electrodonkey/angst/hardware/docs/Angst_3D.PNG

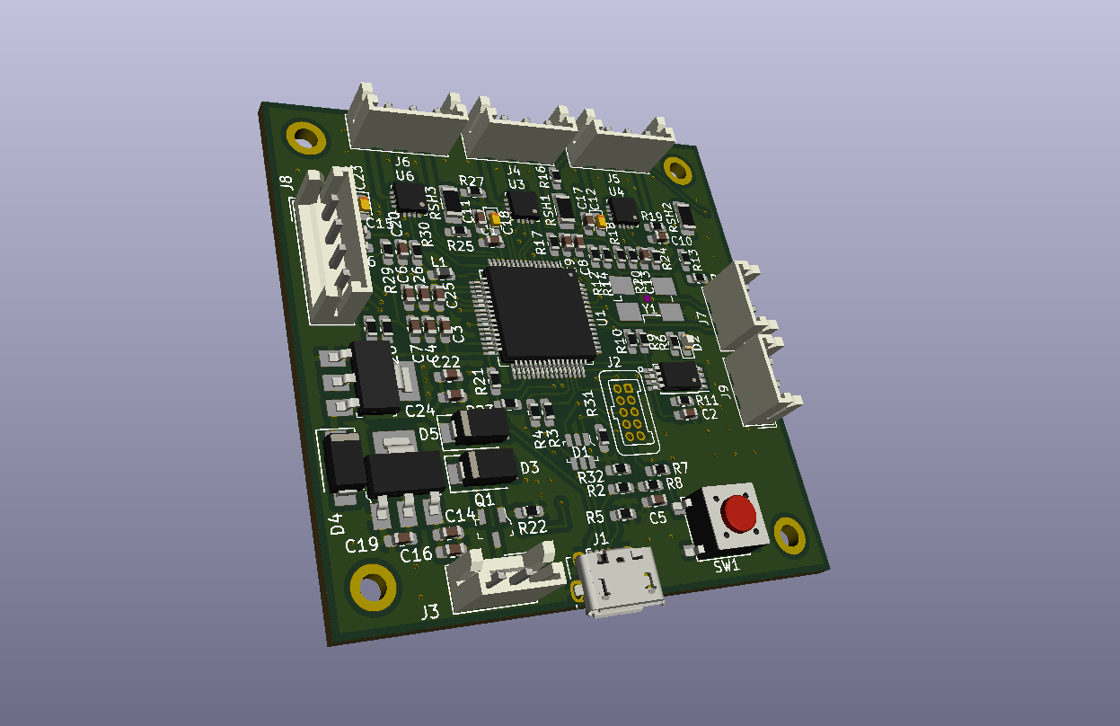
hardware/docs/Angst_3D.PNG
