electrodonkey/angst/README.md

# ANGST - Angle seNsor Gimbal SysTem

## Master thesis project in Advanced Microelectronics
