electrodonkey/angst/hardware/docs/Angst_Shopping_Cart.xlsx

ANGST BOM v1.0.0 | 2019-04-26
Reference | Value | Footprint | Quantity/Unit | Unit price | Total Price/Unit | Quantity to buy | Total Price | Mouser PN
R1, R5 | 100k | Resistor_SMD:R_0603_1608Metric_Pad1.05x0.95mm_HandSolder | 2 | 0.02 € | 0.04 € | 50 | 0.95 € | 603-AC0603FR-07100KL
Y1 | Crystal_GND24 | Crystal:Crystal_SMD_0603-4Pin_6.0x3.5mm_HandSoldering | 1 | 0.86 € | 0.86 € | 3 | 2.57 € | 774-406I35D08M00000
U1 | STM32F303RETx | Package_QFP:LQFP-64_10x10mm_P0.5mm | 1 | 6.28 € | 6.28 € | 3 | 18.84 € | 511-STM32F303RET6
L1 | BK1608HS601-T | Inductor_SMD:L_0603_1608Metric_Pad1.05x0.95mm_HandSolder | 1 | 0.04 € | 0.04 € | 50 | 2.05 € | 963-BK1608HS601-T
C1, C2, C3, C4, C5, C6, C7, C16, C24, C25 | 100n | Capacitor_SMD:C_0603_1608Metric_Pad1.05x0.95mm_HandSolder | 10 | 0.03 € | 0.26 € | 100 | 2.60 € | 710-885012206071
U2 | M24C02-RDW | Package_SO:TSSOP-8_4.4x3mm_P0.65mm | 1 | 0.11 € | 0.11 € | 10 | 1.07 € | 511-M24C02-RDW6TP
R8, R9, R10 | 4k7 | Resistor_SMD:R_0603_1608Metric_Pad1.05x0.95mm_HandSolder | 3 | 0.01 € | 0.01 € | 100 | 0.50 € | 603-RC0603FR-074K7L
R11, R14, R20, R27 | 10k | Resistor_SMD:R_0603_1608Metric_Pad1.05x0.95mm_HandSolder | 4 | 0.01 € | 0.02 € | 200 | 1.00 € | 603-RC0603FR-0710KL
SW1 | SW_Push | Button_Switch_SMD:SW_SPST_EVPBF | 1 | 0.35 € | 0.35 € | 5 | 1.74 € | 612-TL3301CF160QJ
R3, R4, R7 | 22 | Resistor_SMD:R_0603_1608Metric_Pad1.05x0.95mm_HandSolder | 3 | 0.01 € | 0.04 € | 100 | 1.20 € | 71-CRCW060322R0FKEAC
D2 | LED | LED_SMD:LED_0603_1608Metric_Pad1.05x0.95mm_HandSolder | 1 | 0.08 € | 0.08 € | 20 | 1.58 € | 743-IN-S63AT5G
R6 | 560 | Resistor_SMD:R_0603_1608Metric_Pad1.05x0.95mm_HandSolder | 1 | 0.01 € | 0.01 € | 200 | 1.00 € | 603-RC0603FR-07560RL
U3, U4, U6 | STSPIN233 | digikey-footprints:VFQFN-16-1EP_3x3mm | 3 | 2.20 € | 6.60 € | 6 | 13.20 € | 511-STSPIN233
R12, R18, R25 | 100 | Resistor_SMD:R_0603_1608Metric_Pad1.05x0.95mm_HandSolder | 3 | 0.01 € | 0.01 € | 200 | 1.00 € | 603-RC0603FR-07100RL
R13, R17, R19, R24, R26, R30 | 18k | Resistor_SMD:R_0603_1608Metric_Pad1.05x0.95mm_HandSolder | 6 | 0.01 € | 0.03 € | 200 | 1.00 € | RC0603FR-0718KL
C8, C9, C10, C11, C13, C15, C17, C20, C21 | 10n | Capacitor_SMD:C_0603_1608Metric_Pad1.05x0.95mm_HandSolder | 9 | 0.02 € | 0.19 € | 100 | 2.10 € | 710-885012206089
R16, R23, R29 | 1k | Resistor_SMD:R_0603_1608Metric_Pad1.05x0.95mm_HandSolder | 3 | 0.01 € | 0.03 € | 100 | 1.00 € | 71-CRCW06031K00FKEAC
R15, R21, R28 | 3k | Resistor_SMD:R_0603_1608Metric_Pad1.05x0.95mm_HandSolder | 3 | 0.01 € | 0.01 € | 200 | 1.00 € | 603-RC0603FR-073KL
C12, C18, C23 | 22uF 20V | Capacitor_Tantalum_SMD:CP_EIA-1608-08_AVX-J_Pad1.25x1.05mm_HandSolder | 3 | 0.17 € | 0.50 € | 10 | 1.66 € | TAJB226K016TNJ
RSH1, RSH2, RSH3 | 1 0.5W | Resistor_SMD:R_1206_3216Metric_Pad1.42x1.75mm_HandSolder | 3 | 0.06 € | 0.17 € | 20 | 1.16 € | RLP73K2B1R0JTD
J4, J5, J6 | Conn_01x03 | Connector_JST:JST_EH_B3B-EH-A_1x03_P2.50mm_Vertical | 3 | 0 | 0.00 € | 10 | 0.00 €
J2 | Conn_02x05_Odd_Even | Connector_Harwin:Harwin_Gecko-G125-FVX1005L0X_2x05_P1.25mm_Vertical | 1 | 0 | 0.00 € | 3 | 0.00 €
D5 | STPS2L30 | Diode_SMD:D_SMA | 1 | 0.31 € | 0.31 € | 10 | 3.13 € | 511-STPS2L30A
C14, C19, C22, C26 | 1u | Capacitor_SMD:C_0603_1608Metric_Pad1.05x0.95mm_HandSolder | 4 | 0.03 € | 0.12 € | 50 | 1.50 € | CGA3E1X7R1C105M080AC
J1 | USB_B_Micro | Connector_USB:USB_Micro-B_Molex-105017-0001 | 1 | 0.68 € | 0.68 € | 5 | 3.41 € | 538-105017-0001
D1 | USBLC6-4SC6 | digikey-footprints:SOT23-6L | 1 | 0.42 € | 0.42 € | 6 | 2.51 € | 511-USBLC6-4SC6
R2 | 1k5 | Resistor_SMD:R_0603_1608Metric_Pad1.05x0.95mm_HandSolder | 1 | 0.01 € | 0.01 € | 200 | 1.00 € | RC0603FR-071K5L
U7 | TLV1117-33 | digikey-footprints:SOT-223 | 1 | 0.54 € | 0.54 € | 5 | 2.70 € | 595-TLV1117-33CDCYR
U5 | TLV1117-50 | digikey-footprints:SOT-223 | 1 | 0.54 € | 0.54 € | 5 | 2.70 € | 595-TLV1117-50CDCYR
Q1 | IRLML6401TRPBF | digikey-footprints:SOT-23-3 | 1 | 0.37 € | 0.37 € | 5 | 1.83 € | 942-IRLML6401TRPBF
R22 | 2k2 | Resistor_SMD:R_0603_1608Metric_Pad1.05x0.95mm_HandSolder | 1 | 0.01 € | 0.01 € | 200 | 1.00 € | 603-RC0603FR-072K2L
D3 | SMAJ8.5CALFCT-ND | Diode_SMD:D_SMA | 1 | 0.39 € | 0.39 € | 5 | 1.97 € | 576-SMAJ8.5CA
D4 | STPS2L30 | Diode_SMD:D_SMA | 1 | 0 | 0.00 € | 0 | 0.00 €
R31, R32 | 47k | Resistor_SMD:R_0603_1608Metric_Pad1.05x0.95mm_HandSolder | 2 | 0.01 € | 0.01 € | 200 | 1.00 € | RC0603JR-0747KL
J3, J7, J9 | Conn_01x02_Male | Connector_JST:JST_EH_B2B-EH-A_1x02_P2.50mm_Vertical | 3 | 0 | 0.00 € | 10 | 0.00 €
J8 | Conn_01x04_Male | Connector_JST:JST_EH_B4B-EH-A_1x04_P2.50mm_Vertical | 1 | 0 | 0.00 € | 10 | 0.00 €
 |  |  | TOTAL |  | 19.03 |  | 79.972
