electrodonkey/angst/hardware/pcb/angst.pdf

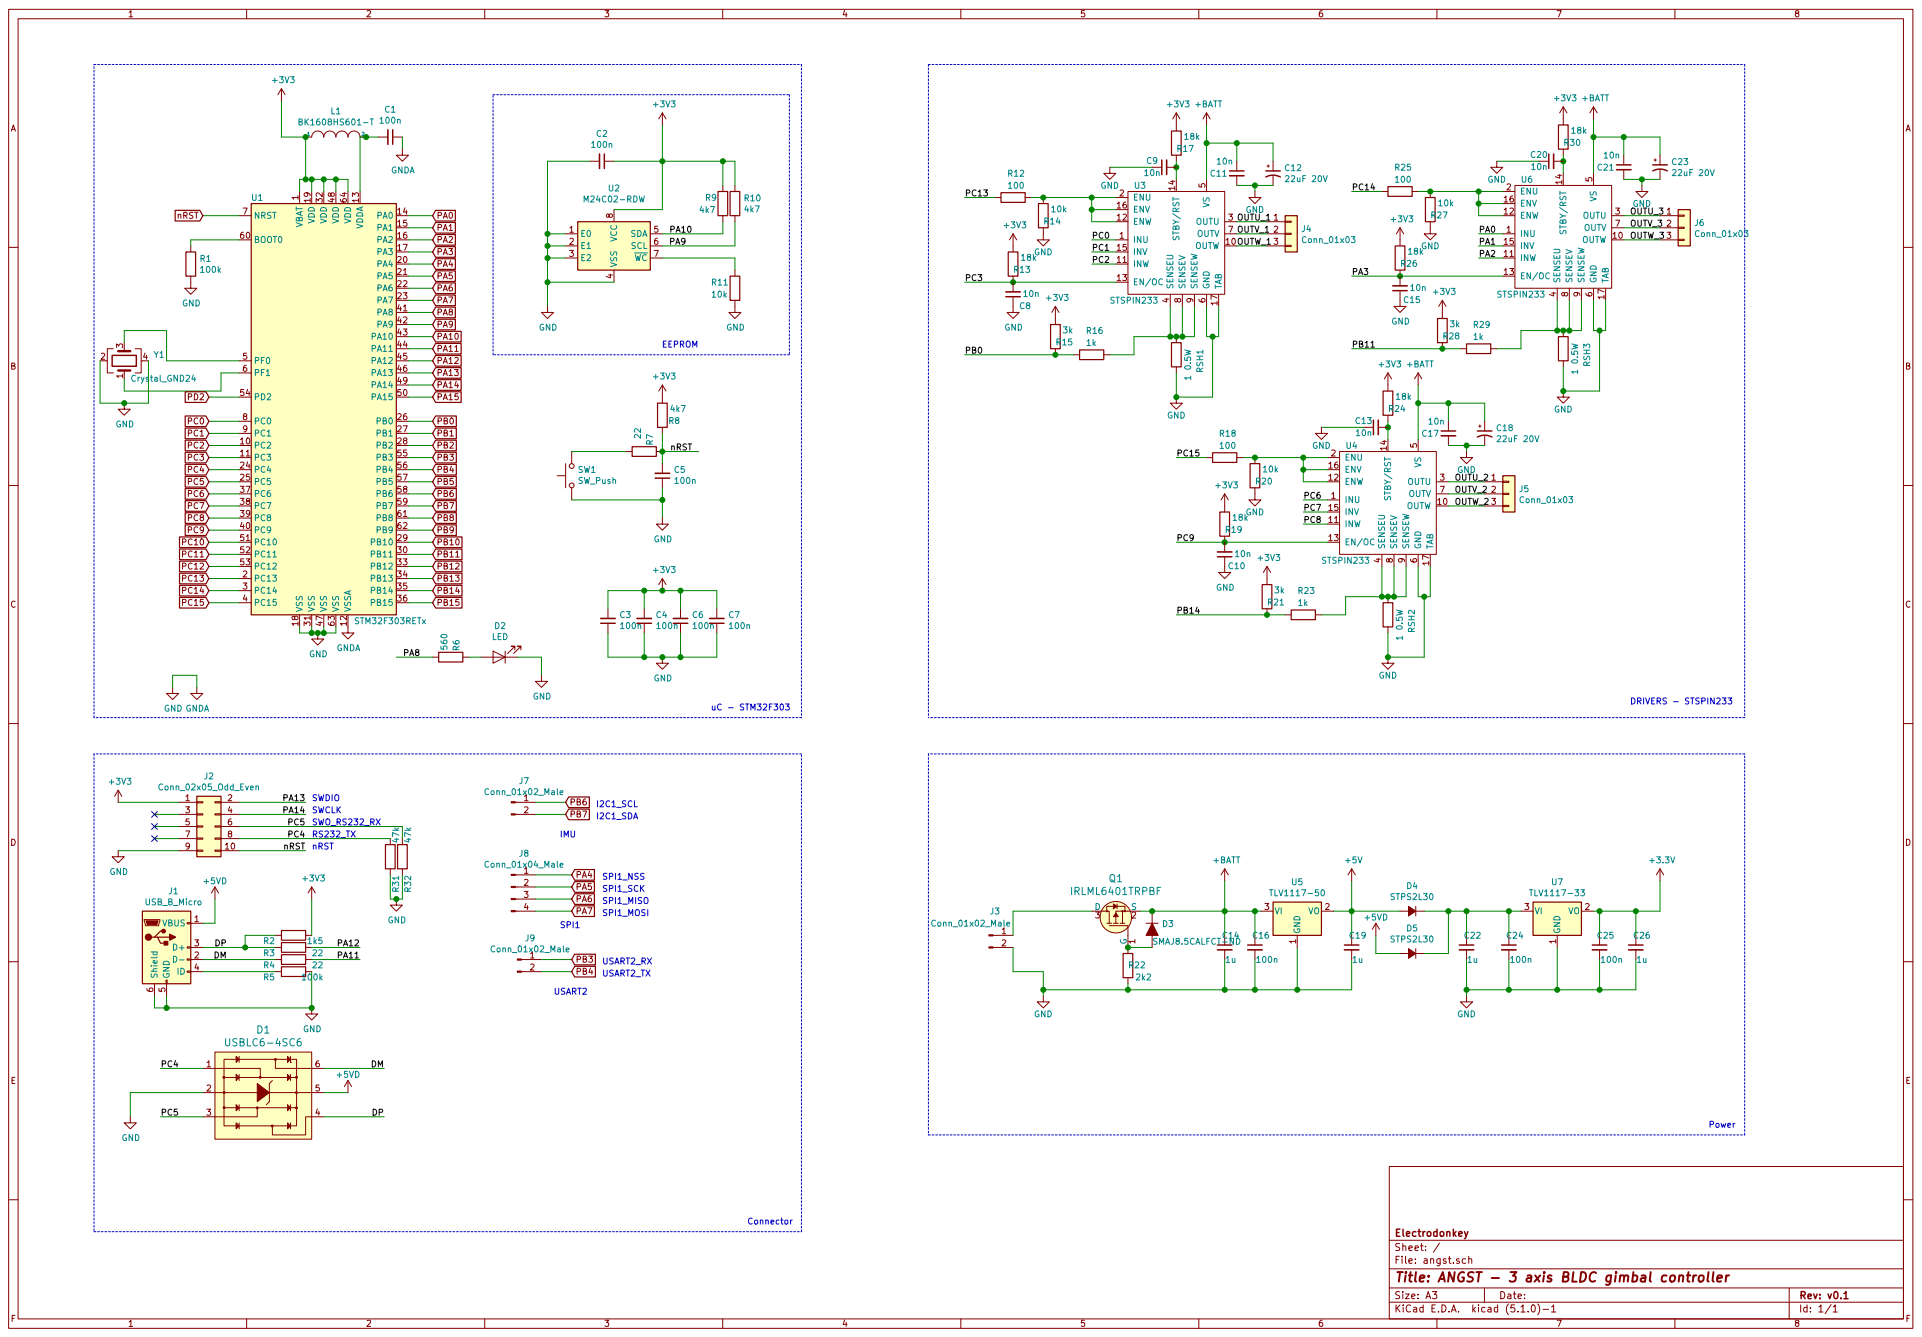
[picture p2: page 1]

1 VDD 19 VDD 32 VDD 48 VDD 64 VDDA 13 VSS 18 VSS 31 VSS 47 VSS 63 VSSA 12 U1 STM32F303RETx PD2 PC0 PC1 PC2 PC3 PC4 PC5 PC6 PC7 PC8 PC9 PC10 PC11 PC12 PC13 PC14 PC15 GND

4 SDA 5 SCL 6 WC 7 VCC

Id: 1/1 Title: ANGST - 3 axis BLDC gimbal controller File: angst.sch Sheet: / Electrodonkey
