electrodonkey/angst/hardware/pcb/angst.kicad_pcb

## KiCad design hardware/pcb/angst.kicad_pcb (2019-04-26)

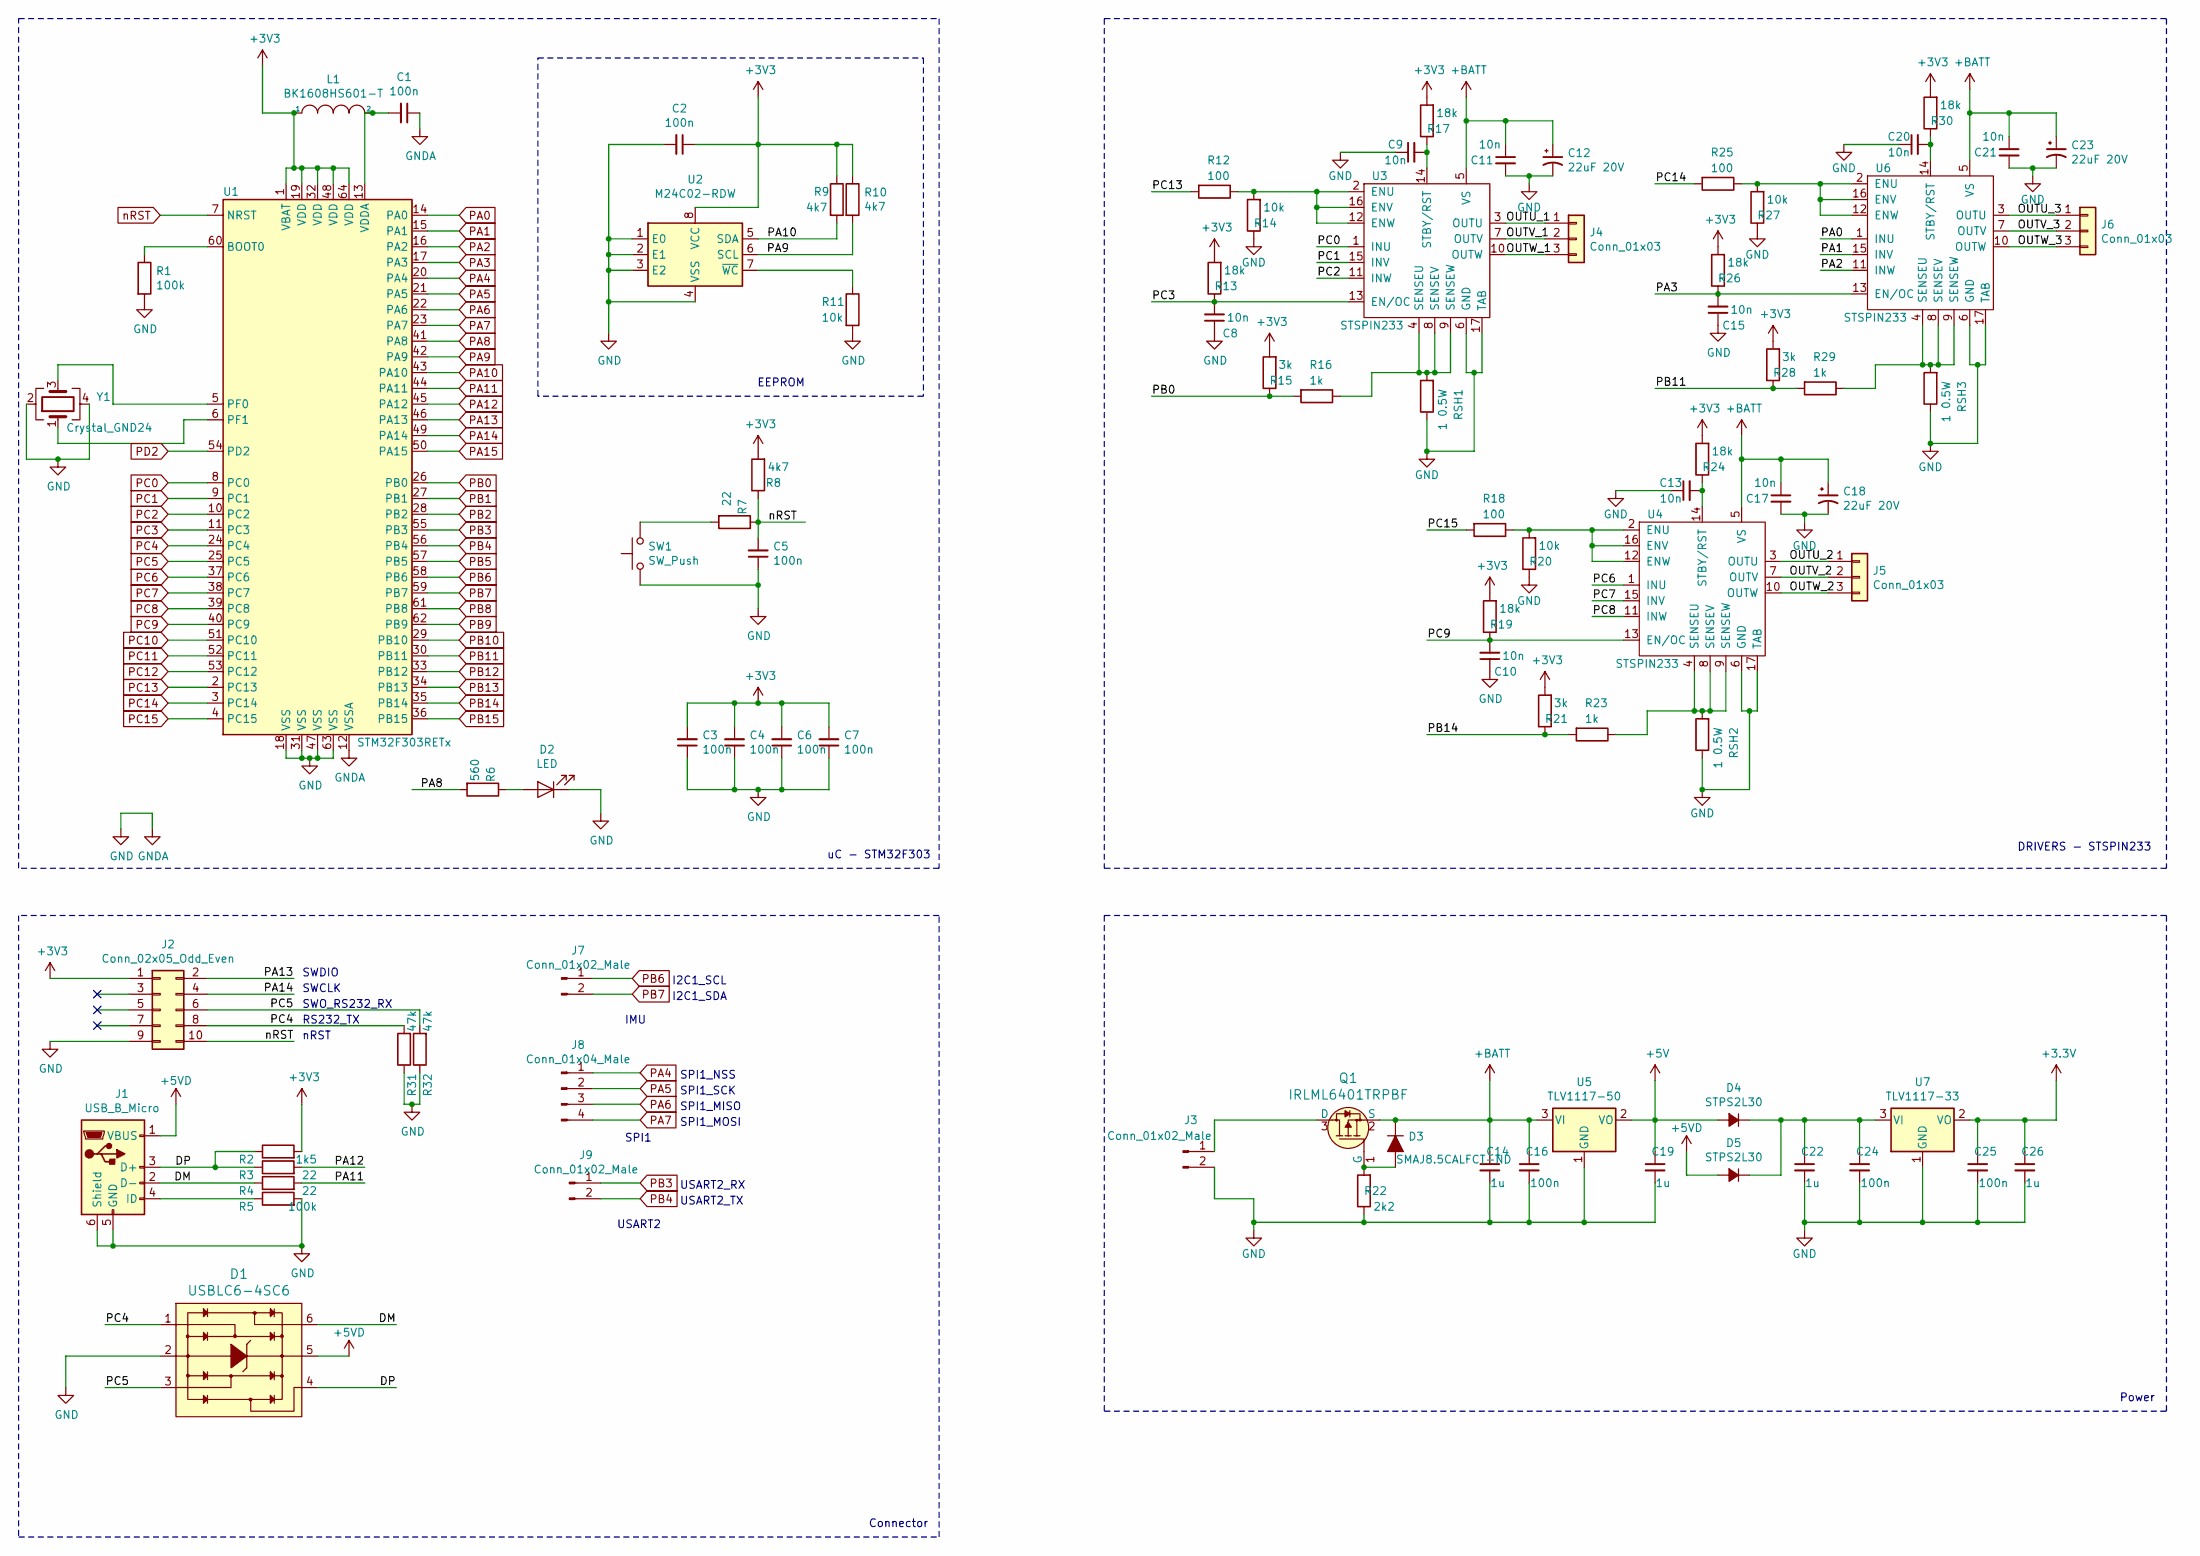
[picture p3: schematic angst.sch, ANGST - 3 axis BLDC gimbal controller]

Parts:
C1, C2, C3, C4, C5, C6, C7, C16, C24, C25: 100n; C_0603_1608Metric_Pad1.05x0.95mm_HandSolder
C8, C9, C10, C11, C13, C15, C17, C20, C21: 10n; C_0603_1608Metric_Pad1.05x0.95mm_HandSolder
C12, C18, C23: 22uF 20V; CP_EIA-1608-08_AVX-J_Pad1.25x1.05mm_HandSolder
C14, C19, C22, C26: 1u; C_0603_1608Metric_Pad1.05x0.95mm_HandSolder
D1: USBLC6-4SC6; SOT23-6L; MPN USBLC6-4SC6; Digi-Key_PN 497-4492-1-ND
D2: LED; LED_0603_1608Metric_Pad1.05x0.95mm_HandSolder
D3: SMAJ8.5CALFCT-ND; D_SMA
D4, D5: STPS2L30; D_SMA
J1: USB_B_Micro; USB_Micro-B_Molex-105017-0001
J2: Conn_02x05_Odd_Even; Harwin_Gecko-G125-FVX1005L0X_2x05_P1.25mm_Vertical
J3, J7, J9: Conn_01x02_Male; JST_EH_B2B-EH-A_1x02_P2.50mm_Vertical
J4, J5, J6: Conn_01x03; JST_EH_B3B-EH-A_1x03_P2.50mm_Vertical
J8: Conn_01x04_Male; JST_EH_B4B-EH-A_1x04_P2.50mm_Vertical
L1: BK1608HS601-T; L_0603_1608Metric_Pad1.05x0.95mm_HandSolder
Q1: IRLML6401TRPBF; SOT-23-3; MPN IRLML6401TRPBF; Digi-Key_PN IRLML6401PBFCT-ND
R1, R5: 100k; R_0603_1608Metric_Pad1.05x0.95mm_HandSolder
R2: 1k5; R_0603_1608Metric_Pad1.05x0.95mm_HandSolder
R3, R4, R7: 22; R_0603_1608Metric_Pad1.05x0.95mm_HandSolder
R6: 560; R_0603_1608Metric_Pad1.05x0.95mm_HandSolder
R8, R9, R10: 4k7; R_0603_1608Metric_Pad1.05x0.95mm_HandSolder
R11, R14, R20, R27: 10k; R_0603_1608Metric_Pad1.05x0.95mm_HandSolder
R12, R18, R25: 100; R_0603_1608Metric_Pad1.05x0.95mm_HandSolder
R13, R17, R19, R24, R26, R30: 18k; R_0603_1608Metric_Pad1.05x0.95mm_HandSolder
R15, R21, R28: 3k; R_0603_1608Metric_Pad1.05x0.95mm_HandSolder
R16, R23, R29: 1k; R_0603_1608Metric_Pad1.05x0.95mm_HandSolder
R22: 2k2; R_0603_1608Metric_Pad1.05x0.95mm_HandSolder
R31, R32: 47k; R_0603_1608Metric_Pad1.05x0.95mm_HandSolder
RSH1, RSH2, RSH3: 1 0.5W; R_1206_3216Metric_Pad1.42x1.75mm_HandSolder
SW1: SW_Push; SW_SPST_EVPBF
U1: STM32F303RETx; LQFP-64_10x10mm_P0.5mm
U2: M24C02-RDW; TSSOP-8_4.4x3mm_P0.65mm
U3, U4, U6: STSPIN233; VFQFN-16-1EP_3x3mm
U5: TLV1117-50; SOT-223
U7: TLV1117-33; SOT-223
Y1: Crystal_GND24; Crystal_SMD_0603-4Pin_6.0x3.5mm_HandSoldering

Connections:
+5V: C19.1, D4.2 (A), U5.2 (VO)
+5VD: D1.5, D5.2 (A), J1.1 (VBUS)
+BATT: C11.1, C12.1, C14.1, C16.1, C17.1, C18.1, C21.1, C23.1, D3.1 (K), Q1.2 (S), U3.5 (VS), U4.5 (VS), U5.3 (VI), U6.5 (VS)
/DM: D1.6, J1.2 (D-), R4.1
/DP: D1.4, J1.3 (D+), R2.1, R3.1
/OUTU_1: J4.1, U3.3 (OUTU)
/OUTU_2: J5.1, U4.3 (OUTU)
/OUTU_3: J6.1, U6.3 (OUTU)
/OUTV_1: J4.2, U3.7 (OUTV)
/OUTV_2: J5.2, U4.7 (OUTV)
/OUTV_3: J6.2, U6.7 (OUTV)
/OUTW_1: J4.3, U3.10 (OUTW)
/OUTW_2: J5.3, U4.10 (OUTW)
/OUTW_3: J6.3, U6.10 (OUTW)
GND: C1.1, C2.2, C3.1, C4.1, C5.1, C6.1, C7.1, C8.1, C9.1, C10.1, C11.2, C12.2, C13.1, C14.2, C15.1, C16.2, C17.2, C18.2, C19.2, C20.1, C21.2, C22.2, C23.2, C24.2, C25.2, C26.2, D1.2, D2.1 (K), J1.5 (GND), J1.6 (Shield), J2.9, J3.2, R1.2, R5.2, R11.2, R14.1, R20.1, R22.1, R27.1, R31.1, R32.1, RSH1.1, RSH2.1, RSH3.1, SW1.1, U1.12 (VSSA), U1.18 (VSS), U1.31 (VSS), U1.47 (VSS), U1.63 (VSS), U2.1 (E0), U2.2 (E1), U2.3 (E2), U2.4 (VSS), U3.6 (GND), U3.17 (TAB), U4.6 (GND), U4.17 (TAB), U5.1 (GND), U6.6 (GND), U6.17 (TAB), U7.1 (GND), Y1.2, Y1.4
unnamed: C1.2, L1.2, U1.13 (VDDA)
unnamed: C9.2, R17.1, U3.14 (STBY/RST)
unnamed: C13.2, R24.1, U4.14 (STBY/RST)
unnamed: C20.2, R30.1, U6.14 (STBY/RST)
unnamed: C22.1, C24.1, D4.1 (K), D5.1 (K), U7.3 (VI)
unnamed: D2.2 (A), R6.1
unnamed: D3.2 (A), Q1.1 (G), R22.2
unnamed: J1.4 (ID), R5.1
unnamed: J3.1, Q1.3 (D)
unnamed: R1.1, U1.60 (BOOT0)
unnamed: R7.2, SW1.2
unnamed: R11.1, U2.7 (~WC)
unnamed: R12.1, R14.2, U3.2 (ENU), U3.12 (ENW), U3.16 (ENV)
unnamed: R16.1, RSH1.2, U3.4 (SENSEU), U3.8 (SENSEV), U3.9 (SENSEW)
unnamed: R18.1, R20.2, U4.2 (ENU), U4.12 (ENW), U4.16 (ENV)
unnamed: R23.1, RSH2.2, U4.4 (SENSEU), U4.8 (SENSEV), U4.9 (SENSEW)
unnamed: R25.1, R27.2, U6.2 (ENU), U6.12 (ENW), U6.16 (ENV)
unnamed: R29.1, RSH3.2, U6.4 (SENSEU), U6.8 (SENSEV), U6.9 (SENSEW)
unnamed: U1.5 (PF0), Y1.3
unnamed: U1.6 (PF1), Y1.1
PA0: U1.14 (PA0), U6.1 (INU)
PA1: U1.15 (PA1), U6.15 (INV)
PA2: U1.16 (PA2), U6.11 (INW)
PA3: C15.2, R26.1, U1.17 (PA3), U6.13 (EN/OC)
PA4: J8.1, U1.20 (PA4)
PA5: J8.2, U1.21 (PA5)
PA6: J8.3, U1.22 (PA6)
PA7: J8.4, U1.23 (PA7)
PA8: R6.2, U1.41 (PA8)
PA9: R10.2, U1.42 (PA9), U2.6 (SCL)
PA10: R9.2, U1.43 (PA10), U2.5 (SDA)
PA11: R4.2, U1.44 (PA11)
PA12: R3.2, U1.45 (PA12)
PA13: J2.2, U1.46 (PA13)
PA14: J2.4, U1.49 (PA14)
PA15: U1.50 (PA15)
PB0: R15.1, R16.2, U1.26 (PB0)
PB1: U1.27 (PB1)
PB2: U1.28 (PB2)
PB3: J9.1, U1.55 (PB3)
PB4: J9.2, U1.56 (PB4)
PB5: U1.57 (PB5)
PB6: J7.1, U1.58 (PB6)
PB7: J7.2, U1.59 (PB7)
PB8: U1.61 (PB8)
PB9: U1.62 (PB9)
PB10: U1.29 (PB10)
PB11: R28.1, R29.2, U1.30 (PB11)
PB12: U1.33 (PB12)
PB13: U1.34 (PB13)
PB14: R21.1, R23.2, U1.35 (PB14)
PB15: U1.36 (PB15)
PC0: U1.8 (PC0), U3.1 (INU)
PC1: U1.9 (PC1), U3.15 (INV)
PC2: U1.10 (PC2), U3.11 (INW)
PC3: C8.2, R13.1, U1.11 (PC3), U3.13 (EN/OC)
PC4: D1.1, J2.8, R31.2, U1.24 (PC4)
PC5: D1.3, J2.6, R32.2, U1.25 (PC5)
PC6: U1.37 (PC6), U4.1 (INU)
PC7: U1.38 (PC7), U4.15 (INV)
PC8: U1.39 (PC8), U4.11 (INW)
PC9: C10.2, R19.1, U1.40 (PC9), U4.13 (EN/OC)
PC10: U1.51 (PC10)
PC11: U1.52 (PC11)
PC12: U1.53 (PC12)
PC13: R12.2, U1.2 (PC13)
PC14: R25.2, U1.3 (PC14)
PC15: R18.2, U1.4 (PC15)
PD2: U1.54 (PD2)
nRST: C5.2, J2.10, R7.1, R8.1, U1.7 (NRST)

Notes on the sheet:
EEPROM
uC - STM32F303
DRIVERS - STSPIN233
Power
SWDIO
SWCLK
SWO_RS232_RX
RS232_TX
nRST
I2C1_SCL
I2C1_SDA
IMU
SPI1_NSS
SPI1_SCK
SPI1_MISO
SPI1_MOSI
USART2_RX
USART2_TX
USART2
SPI1
Connector

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
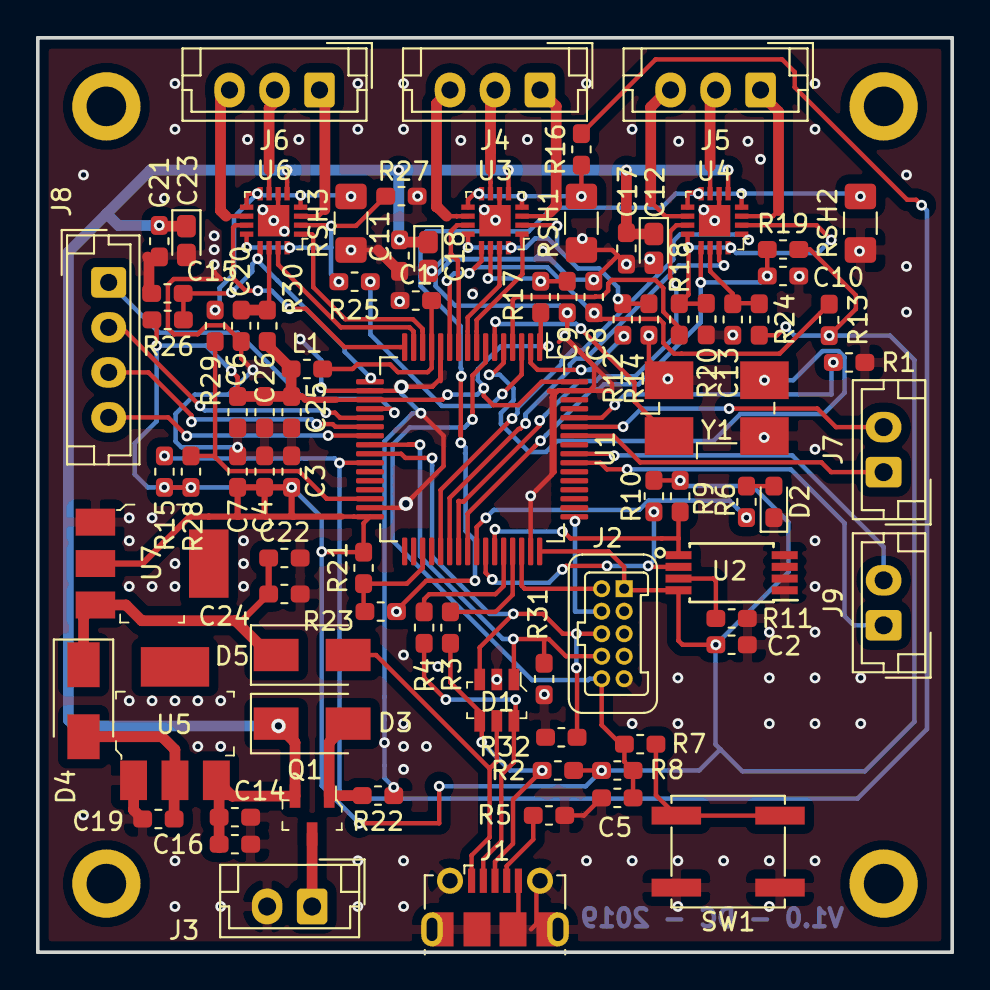
[picture p4: board angst.kicad_pcb from above]

Board: 2 copper layers, 50.8 x 50.8 mm, 86 parts (0 on the bottom side), 72 nets.
