electrodonkey/angst/(commit log)

2019-04-15 Add initial KiCad files
    [angst.kicad_pcb, angst.sch]
2019-04-15 Finish work on MCU block, start work on driver block
    [angst.sch]
2019-04-15 Add motor driver block and connector block.
    [angst.sch]
2019-04-16 Add power block
    [angst.sch]
2019-04-18 Clean up power concept. Add connector block
    [angst.sch]
2019-04-18 Removed Driver_Motor, unused lib
2019-04-18 Add bead footprint
    [angst.sch]
2019-04-18 Add pin assigment file for STM32 uC
    [STM32F303_LQFP64_PinAssignment.xlsx]
2019-04-19 Add stm32 datasheet
    [STM32F303_LQFP64_PinAssignment.xlsx]
2019-04-19 Start work on PCB layout
    [angst.sch]
2019-04-19 Add initial placement of components on layout
    [angst.kicad_pcb]
2019-04-20 Continue work on power block layout
    [angst.kicad_pcb]
2019-04-23 Add work on drivers
    [angst.kicad_pcb]
2019-04-25 Continue layout
    [angst.kicad_pcb]
2019-04-25 Ratnest finished, start arranging graphics
    [angst.kicad_pcb]
2019-04-25 Work on layout
    [angst.kicad_pcb]
2019-04-26 Finish layout and board art. V1.0 production ready
    [angst.kicad_pcb]
2019-04-26 Add schematic.pdf
2019-04-26 Add part list
    [Angst_Shopping_Cart.xlsx]
2019-04-26 Update shopping list
    [Angst_Shopping_Cart.xlsx]
2019-05-02 Clean up BOM
    [Angst_Shopping_Cart.xlsx]
